cansat-ptl/cubesat-boards/cubesat-brdtemplate/cubesat-board.kicad_pcb

## KiCad design cubesat-brdtemplate/cubesat-board.kicad_pcb (2020-03-30)

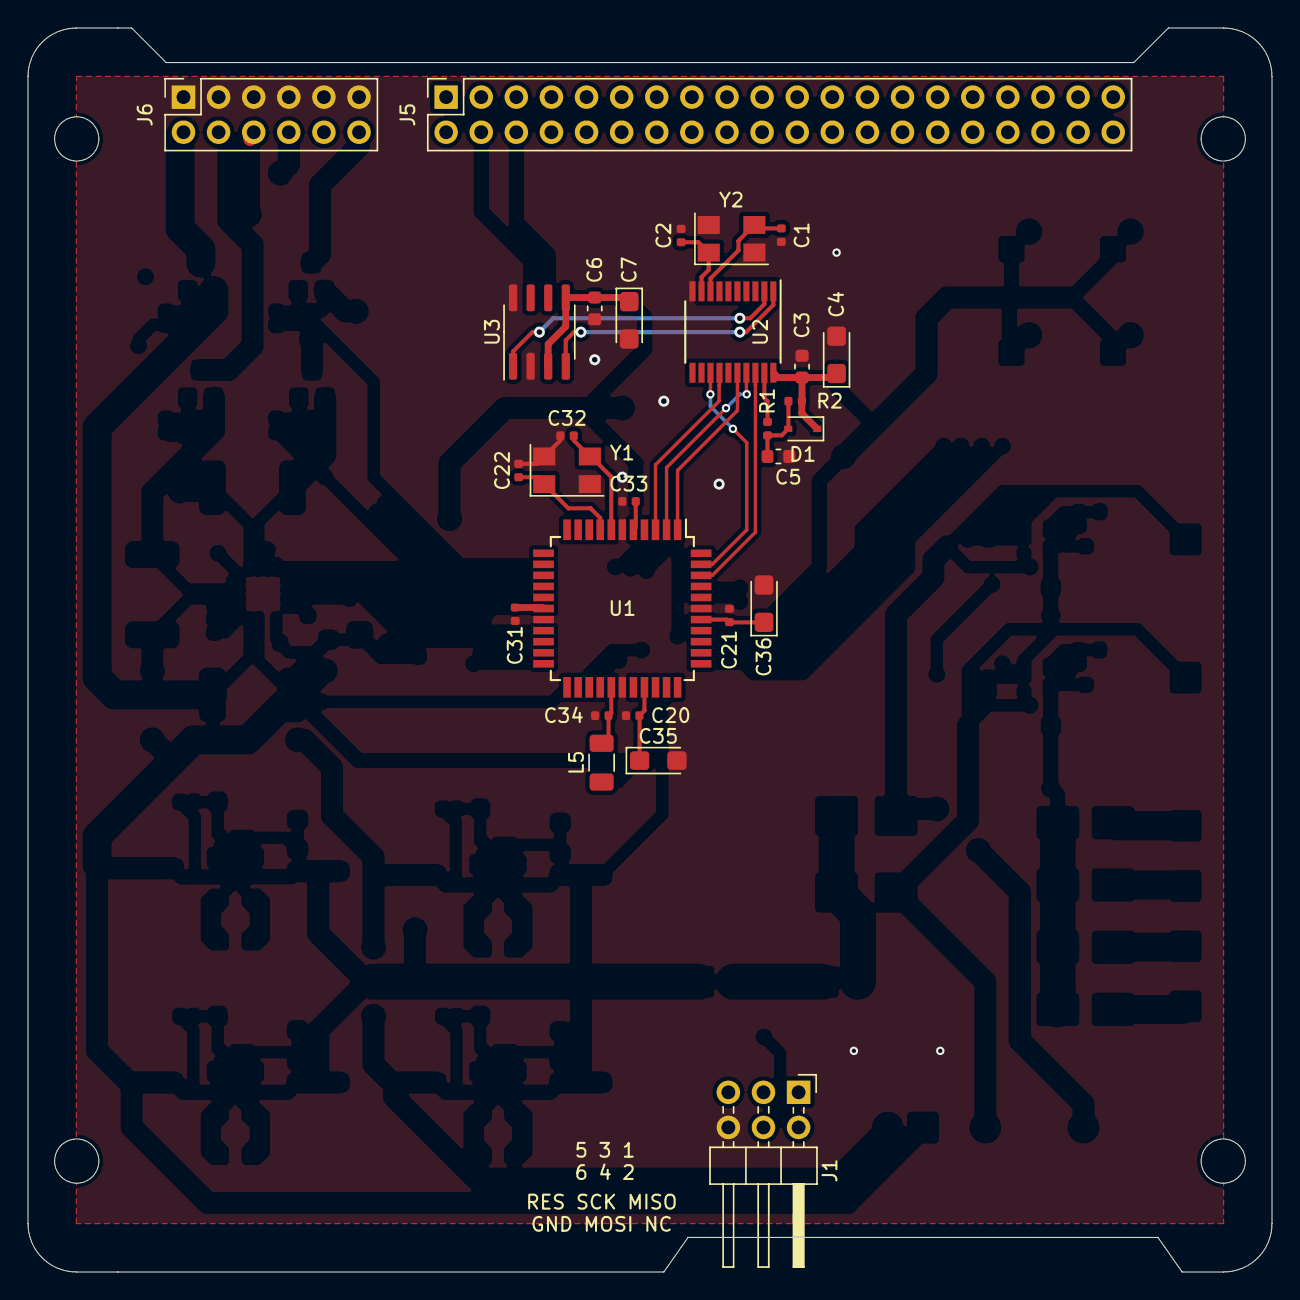
[picture p1: board cubesat-board.kicad_pcb from above]

Board: 2 copper layers, 90.0 x 90.0 mm, 28 parts (0 on the bottom side), 19 nets.

Parts:
C1, C2, C22, C32: 22pF; C_0402_1005Metric
C3, C5, C6: 100nF; C_0603_1608Metric
C4, C7, C35, C36: 22uF; CP_EIA-3216-10_Kemet-I
C20, C21, C31, C33, C34: 100nF; C_0402_1005Metric
D1: Generic; D_SOD-323
J1: ICSP; PinHeader_2x03_P2.54mm_Horizontal
J5: Conn_02x20_Odd_Even_MountingPin; PinSocket_2x20_P2.54mm_Vertical
J6: PWR_HEAD; PinSocket_2x06_P2.54mm_Vertical
L5: Ferrite; L_1206_3216Metric
R1, R2: 1K; R_0402_1005Metric
U1: ATmega644A-AU; TQFP-44_10x10mm_P0.8mm
U2: MCP2515-xST; TSSOP-20_4.4x6.5mm_P0.65mm
U3: TJA1051T-3; SOIC-8_3.9x4.9mm_P1.27mm
Y1: 8 MHz; Crystal_SMD_5032-4Pin_5.0x3.2mm
Y2: 12 MHz; Crystal_SMD_5032-4Pin_5.0x3.2mm

Connections:
+5V: C3.1, C4.1, C6.1, C7.1, C20.1, C21.1, C31.1, C33.1, C35.1, C36.1, D1.1, J6.8, L5.1, R2.1, U1.5, U1.17, U1.38, U2.20, U3.3, U3.5
/ICSP_MISO: J1.1, U1.2, U2.17
/ICSP_MOSI: J1.4, U1.1, U2.16
/ICSP_RESET: J1.5, U1.4
/ICSP_SCK: J1.3, U1.3, U2.14
/PWR_CANBUS/MCP_!CS: U1.42, U2.18
/PWR_CANBUS/MCP_!INT: U1.43, U2.13
CANH: J5.4, U3.7
CANL: J5.6, U3.6
GND: C1.2, C2.2, C3.2, C4.2, C5.2, C6.2, C7.2, C20.2, C21.2, C22.2, C31.2, C32.2, C33.2, C34.2, C35.2, C36.2, J1.6, J6.1, J6.3, J6.5, J6.7, J6.9, J6.11, U1.6, U1.18, U1.28, U1.39, U2.10, U3.2, U3.8, Y1.2, Y1.4, Y2.2, Y2.4
unnamed: C1.1, U2.8, Y2.3
unnamed: C2.1, U2.9, Y2.1
unnamed: C5.1, D1.2, R1.1, R2.2
unnamed: C22.1, U1.8, Y1.1
unnamed: C32.1, U1.7, Y1.3
unnamed: C34.1, L5.2, U1.27
unnamed: R1.2, U2.19
unnamed: U2.1, U3.4
unnamed: U2.2, U3.1
