cansat-ptl/cubesat-boards/cubesat-fcu/cubesat-fcu.kicad_pcb

## KiCad design cubesat-fcu/cubesat-fcu.kicad_pcb (2020-03-30)

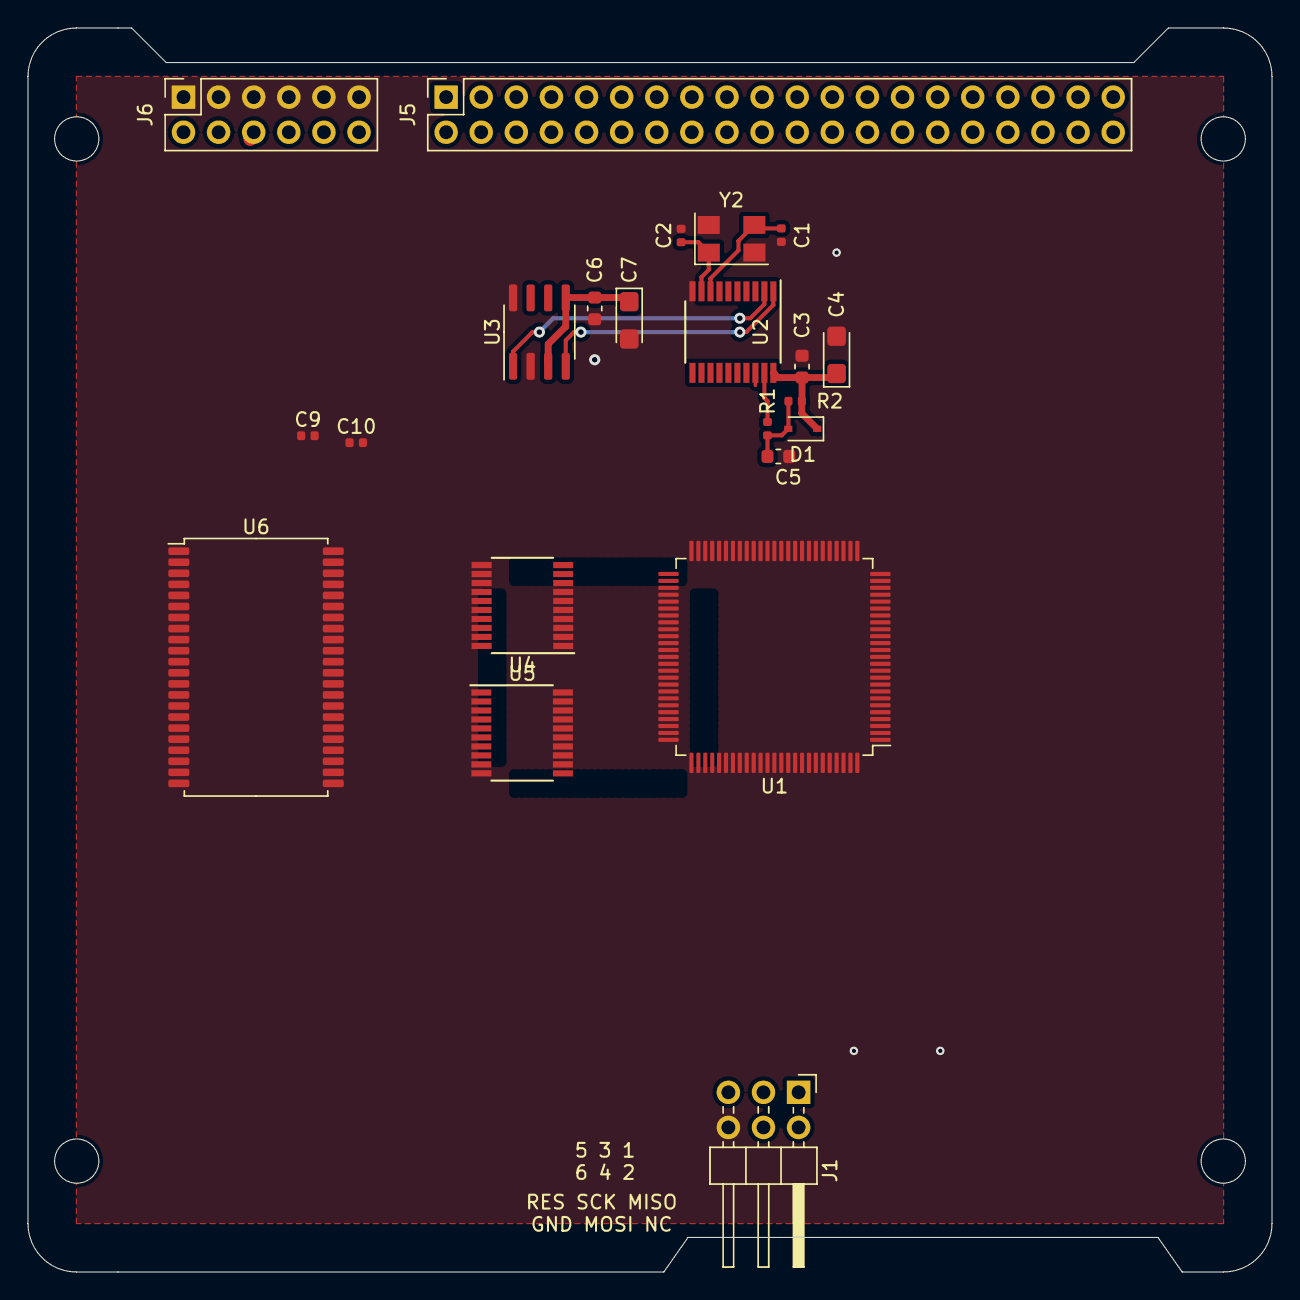
[picture p2: board cubesat-fcu.kicad_pcb from above]

Board: 2 copper layers, 90.0 x 90.0 mm, 22 parts (0 on the bottom side), 45 nets.

Parts:
C1, C2: 22pF; C_0402_1005Metric
C3, C5, C6: 100nF; C_0603_1608Metric
C4, C7: 22uF; CP_EIA-3216-10_Kemet-I
C9, C10: 100nF; C_0402_1005Metric
D1: Generic; D_SOD-323
J1: ICSP; PinHeader_2x03_P2.54mm_Horizontal
J5: Conn_02x20_Odd_Even_MountingPin; PinSocket_2x20_P2.54mm_Vertical
J6: PWR_HEAD; PinSocket_2x06_P2.54mm_Vertical
R1, R2: 1K; R_0402_1005Metric
U1: ATxmega128A1U-AU; TQFP-100_14x14mm_P0.5mm
U2: MCP2515-xST; TSSOP-20_4.4x6.5mm_P0.65mm
U3: TJA1051T-3; SOIC-8_3.9x4.9mm_P1.27mm
U4, U5: 74HC573#SOIC; TSSOP-20_4.4x6.5mm_P0.65mm
U6: IS61C5128AL-10TLI; TSOP-II-44_10.16x18.41mm_P0.8mm
Y2: 12 MHz; Crystal_SMD_5032-4Pin_5.0x3.2mm

Connections:
+3V3-A: C3.1, C4.1, C9.1, C10.1, D1.1, J6.6, R2.1, U2.20, U3.5, U4.20, U5.20, U6.11, U6.33
+5V-A: C6.1, C7.1, J6.2, U3.3
/FCU_MEMORY/FCU_ALE1: U1.57, U4.11
/FCU_MEMORY/FCU_ALE2: U1.58, U5.11
/FCU_MEMORY/FCU_MEM_~OE: U1.56, U6.37
/FCU_MEMORY/FCU_MEM_~WE: U1.55, U6.15
/PJ0: U1.65, U6.9
/PJ1: U1.66, U6.10
/PJ2: U1.67, U6.13
/PJ3: U1.68, U6.14
/PJ4: U1.69, U6.31
/PJ5: U1.70, U6.32
/PJ6: U1.71, U6.35
/PJ7: U1.72, U6.36
/PK0: U1.75, U4.2, U5.2, U6.3
/PK1: U1.76, U4.3, U5.3, U6.4
/PK2: U1.77, U4.4, U5.4, U6.5
/PK3: U1.78, U4.5, U6.6
/PK4: U1.79, U4.6, U6.7
/PK5: U1.80, U4.7, U6.16
/PK6: U1.81, U4.8, U6.17
/PK7: U1.82, U4.9, U6.18
CANH: J5.4, U3.7
CANL: J5.6, U3.6
GND: C1.2, C2.2, C3.2, C4.2, C5.2, C6.2, C7.2, C9.2, C10.2, J1.6, J5.1, J5.2, J5.3, J5.5, J5.7, J5.8, J6.1, J6.3, J6.5, J6.7, J6.9, J6.11, U2.10, U3.2, U3.8, U4.1, U4.10, U5.1, U5.10, U6.8, U6.12, U6.34, Y2.2, Y2.4
unnamed: C1.1, U2.8, Y2.3
unnamed: C2.1, U2.9, Y2.1
unnamed: C5.1, D1.2, R1.1, R2.2
unnamed: R1.2, U2.19
unnamed: U1.4, U1.94
unnamed: U1.3, U1.13, U1.23, U1.33, U1.43, U1.53, U1.63, U1.73, U1.84, U1.93
unnamed: U1.14, U1.24, U1.34, U1.44, U1.54, U1.64, U1.74, U1.83
unnamed: U2.1, U3.4
unnamed: U2.2, U3.1
unnamed: U4.12, U6.38
unnamed: U4.13, U6.30
unnamed: U4.14, U6.29
unnamed: U4.15, U6.28
unnamed: U4.16, U6.27
unnamed: U4.17, U6.26
unnamed: U4.18, U6.20
unnamed: U4.19, U6.19
unnamed: U5.17, U6.41
unnamed: U5.18, U6.40
unnamed: U5.19, U6.39
