cansat-ptl/cubesat-boards/cubesat-power/cubesat-power.kicad_pcb

## KiCad design cubesat-power/cubesat-power.kicad_pcb (2020-03-30)

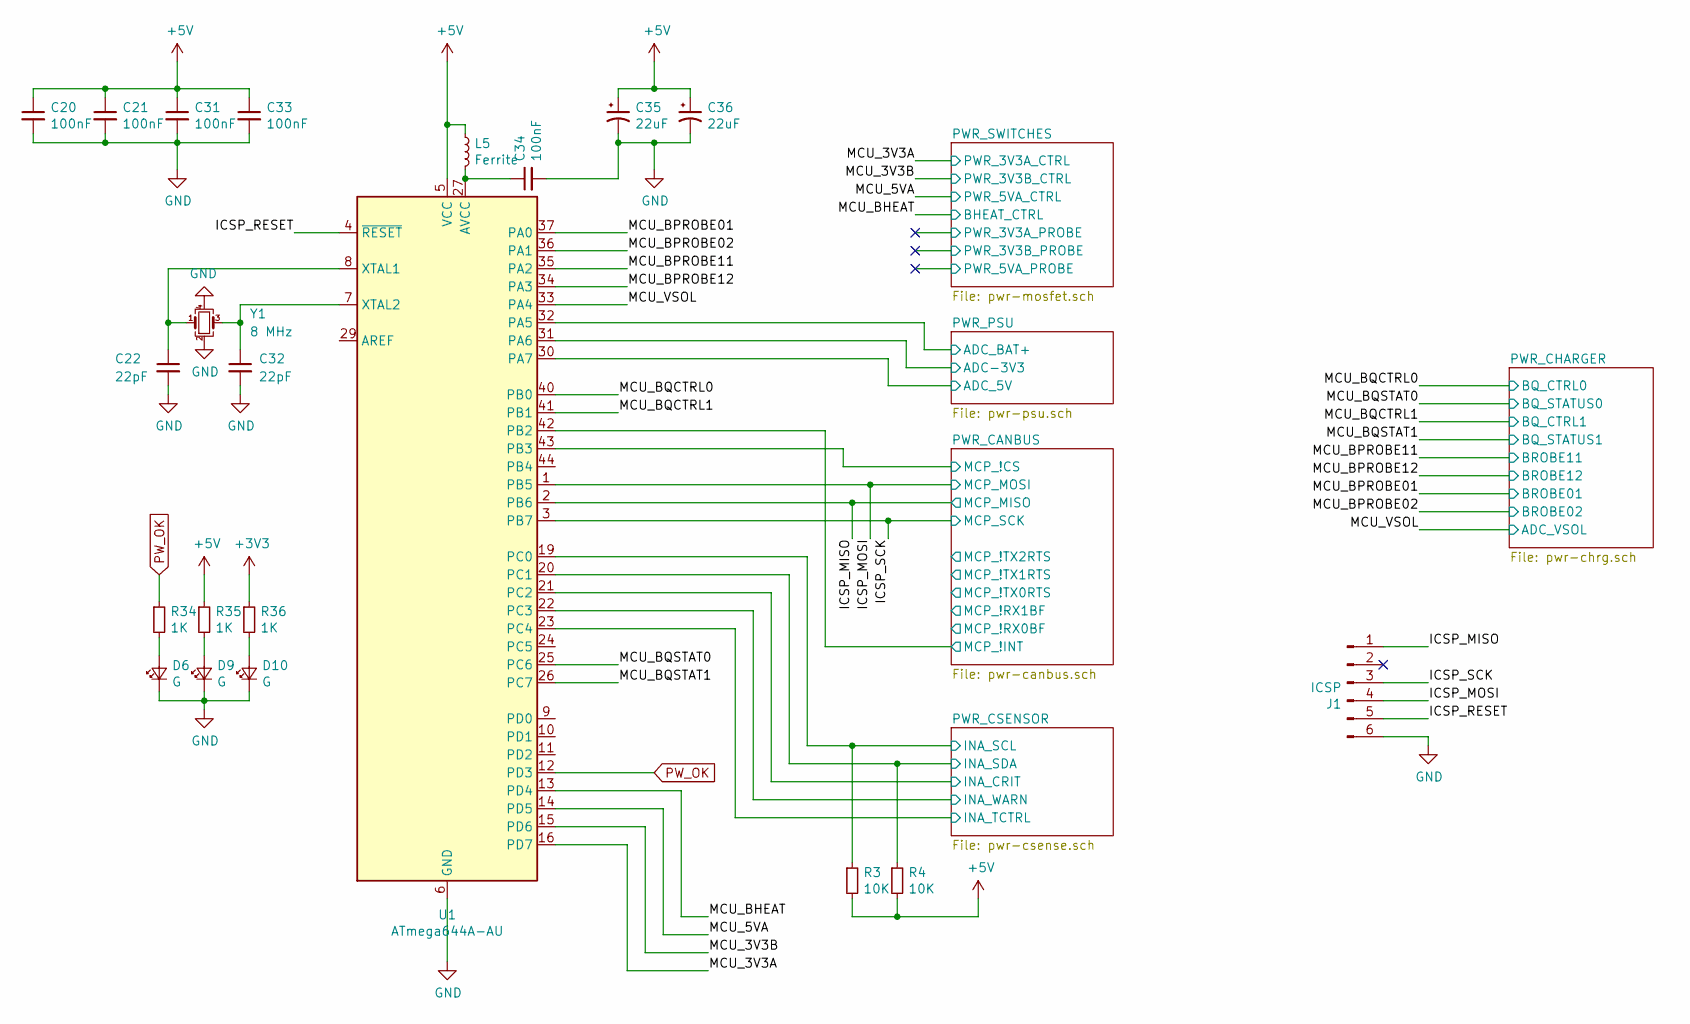
[picture p3: schematic cubesat-power.sch, Yktsat Power Supply Controller]

Parts:
C20, C21, C31, C33, C34: 100nF; C_0402_1005Metric
C22, C32: 22pF; C_0402_1005Metric
C35, C36: 22uF; CP_EIA-3216-10_Kemet-I
D6, D9, D10: G; LED_0603_1608Metric
J1: ICSP; PinHeader_2x03_P2.54mm_Horizontal
L5: Ferrite; L_1206_3216Metric
R3, R4: 10K; R_0402_1005Metric
R34, R35, R36: 1K; R_0603_1608Metric
U1: ATmega644A-AU; TQFP-44_10x10mm_P0.8mm
Y1: 8 MHz; Crystal_SMD_5032-4Pin_5.0x3.2mm; Part 7B-8.000MAAJ-T - CRYSTAL, 8MHZ, 18PF, 5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

Connections:
+3V3: R36.1; also elsewhere on the board
+5V: C20.1, C21.1, C31.1, C33.1, C35.1, C36.1, L5.1, R3.2, R4.2, R35.1, U1.5 (VCC), U1.17 (VCC), U1.30 (PA7), U1.38 (VCC); also elsewhere on the board
+BATT: U1.32 (PA5); also elsewhere on the board
/ICSP_MISO: J1.1, U1.2 (PB6); also elsewhere on the board
/ICSP_MOSI: J1.4, U1.1 (PB5); also elsewhere on the board
/ICSP_RESET: J1.5, U1.4 (~RESET)
/ICSP_SCK: J1.3, U1.3 (PB7); also elsewhere on the board
/MCU_3V3A: U1.16 (PD7); also elsewhere on the board
/MCU_3V3B: U1.15 (PD6); also elsewhere on the board
/MCU_5VA: U1.14 (PD5); also elsewhere on the board
/MCU_BHEAT: U1.13 (PD4); also elsewhere on the board
/MCU_BPROBE01: U1.37 (PA0); also elsewhere on the board
/MCU_BPROBE02: U1.36 (PA1); also elsewhere on the board
/MCU_BPROBE11: U1.35 (PA2); also elsewhere on the board
/MCU_BPROBE12: U1.34 (PA3); also elsewhere on the board
/MCU_BQCTRL0: U1.40 (PB0); also elsewhere on the board
/MCU_BQCTRL1: U1.41 (PB1); also elsewhere on the board
/MCU_BQSTAT0: U1.25 (PC6); also elsewhere on the board
/MCU_BQSTAT1: U1.26 (PC7); also elsewhere on the board
/MCU_VSOL: U1.33 (PA4); also elsewhere on the board
/PWR_CANBUS/MCP_!CS: U1.43 (PB3); also elsewhere on the board
/PWR_CANBUS/MCP_!INT: U1.42 (PB2); also elsewhere on the board
/PWR_CSENSOR/INA_CRIT: U1.21 (PC2); also elsewhere on the board
/PWR_CSENSOR/INA_SCL: R3.1, U1.19 (PC0); also elsewhere on the board
/PWR_CSENSOR/INA_SDA: R4.1, U1.20 (PC1); also elsewhere on the board
/PWR_CSENSOR/INA_TCTRL: U1.23 (PC4); also elsewhere on the board
/PWR_CSENSOR/INA_WARN: U1.22 (PC3); also elsewhere on the board
GND: C20.2, C21.2, C22.2, C31.2, C32.2, C33.2, C34.2, C35.2, C36.2, D6.1 (K), D9.1 (K), D10.1 (K), J1.6, U1.6 (GND), U1.18 (GND), U1.28 (GND), U1.39 (GND), Y1.2, Y1.4; also elsewhere on the board
unnamed: C22.1, U1.8 (XTAL1), Y1.1
unnamed: C32.1, U1.7 (XTAL2), Y1.3
unnamed: C34.1, L5.2, U1.27 (AVCC)
unnamed: D6.2 (A), R34.2
unnamed: D9.2 (A), R35.2
unnamed: D10.2 (A), R36.2
PW_OK: R34.1, U1.12 (PD3); also elsewhere on the board

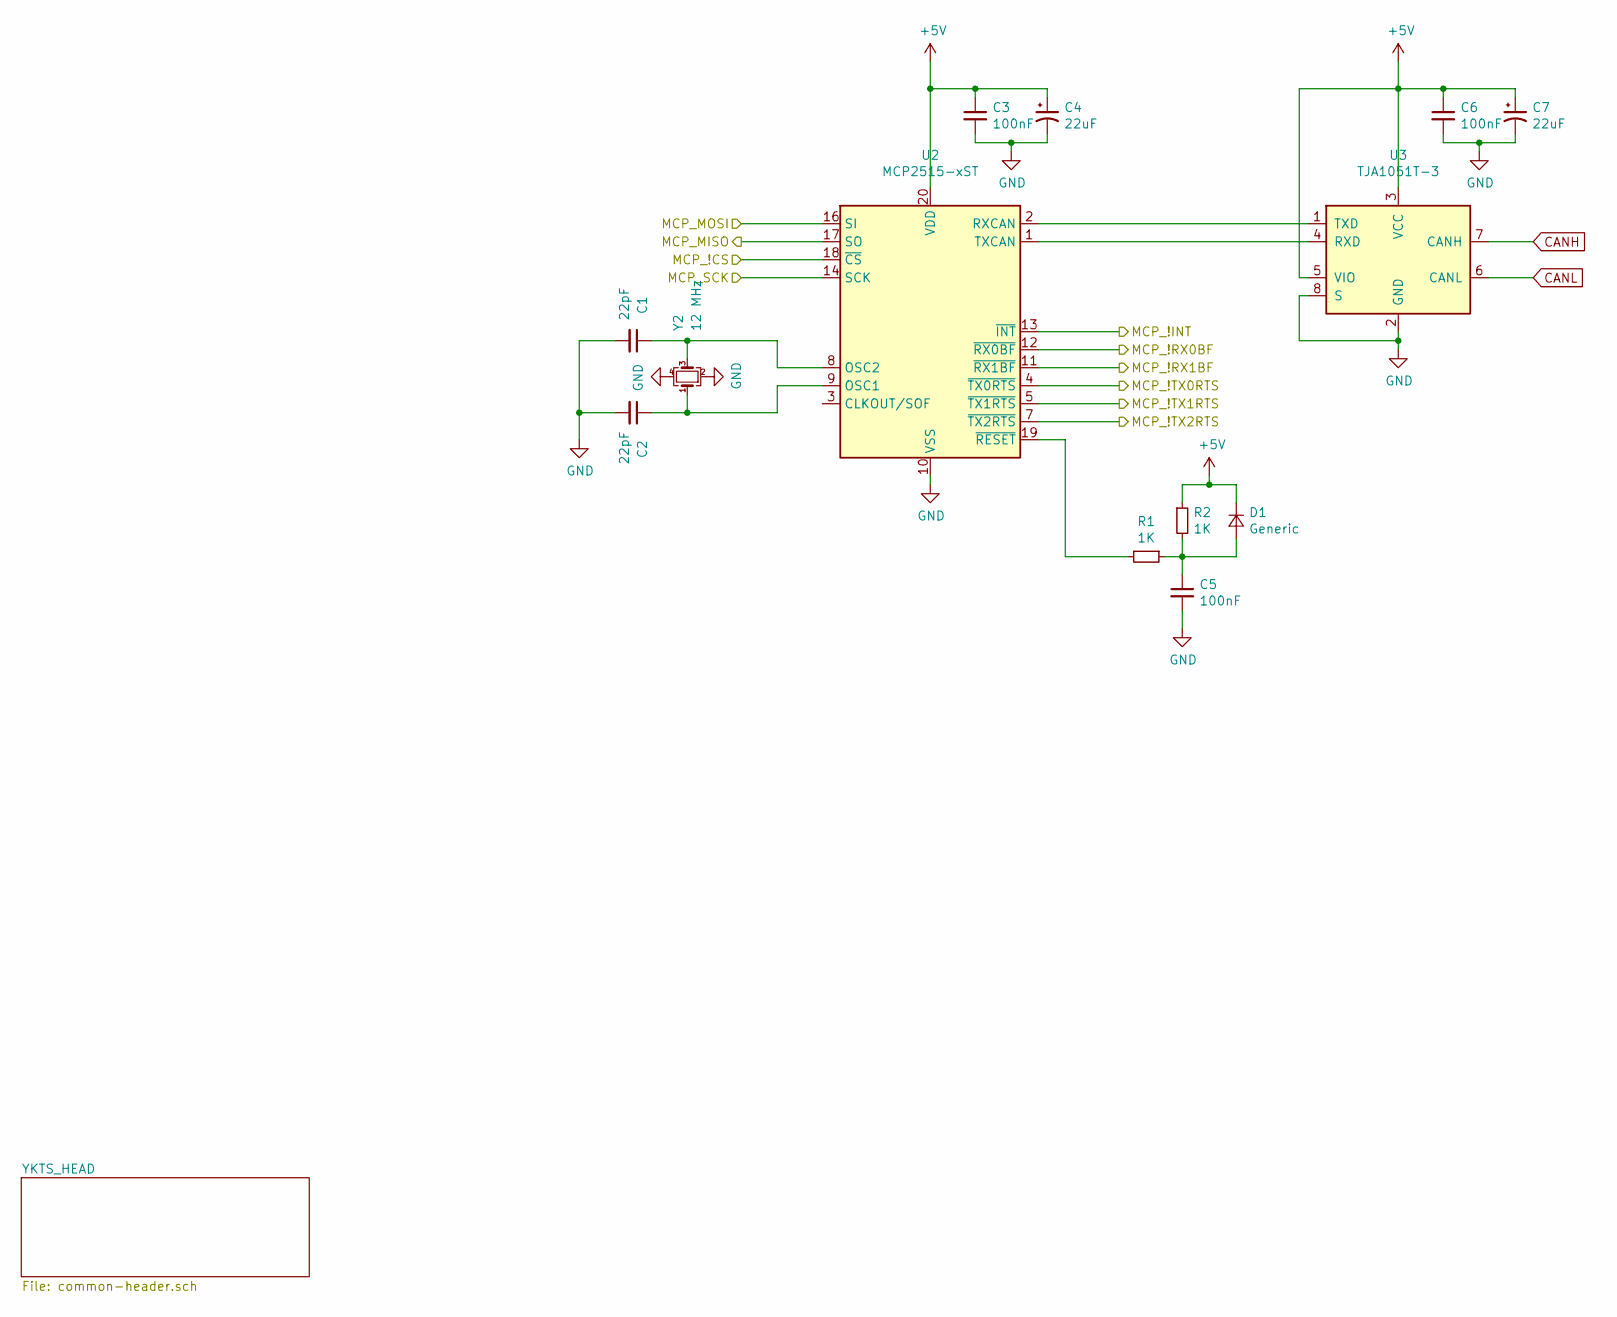
[picture p4: schematic pwr-canbus.sch, Yktsat CANBus Controller]

Parts:
C1, C2: 22pF; C_0402_1005Metric
C3, C5, C6: 100nF; C_0603_1608Metric
C4, C7: 22uF; CP_EIA-3216-10_Kemet-I
D1: Generic; D_SOD-323
R1, R2: 1K; R_0402_1005Metric
U2: MCP2515-xST; TSSOP-20_4.4x6.5mm_P0.65mm
U3: TJA1051T-3; SOIC-8_3.9x4.9mm_P1.27mm
Y2: 12 MHz; Crystal_SMD_5032-4Pin_5.0x3.2mm; Part AB-12.000MALE-T - CRYSTAL, 12MHZ, 12PF,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

Connections:
+5V: C3.1, C4.1, C6.1, C7.1, D1.1 (K), R2.1, U2.20 (VDD), U3.3 (VCC), U3.5 (VIO); also elsewhere on the board
/ICSP_MISO: U2.17 (SO); also elsewhere on the board
/ICSP_MOSI: U2.16 (SI); also elsewhere on the board
/ICSP_SCK: U2.14 (SCK); also elsewhere on the board
/PWR_CANBUS/MCP_!CS: U2.18 (~CS); also elsewhere on the board
/PWR_CANBUS/MCP_!INT: U2.13 (~INT); also elsewhere on the board
CANH: U3.7 (CANH); also elsewhere on the board
CANL: U3.6 (CANL); also elsewhere on the board
GND: C1.2, C2.2, C3.2, C4.2, C5.2, C6.2, C7.2, U2.10 (VSS), U3.2 (GND), U3.8 (S), Y2.2, Y2.4; also elsewhere on the board
unnamed: C1.1, U2.8 (OSC2), Y2.3
unnamed: C2.1, U2.9 (OSC1), Y2.1
unnamed: C5.1, D1.2 (A), R1.1, R2.2
unnamed: R1.2, U2.19 (~RESET)
unnamed: U2.1 (TXCAN), U3.4 (RXD)
unnamed: U2.2 (RXCAN), U3.1 (TXD)

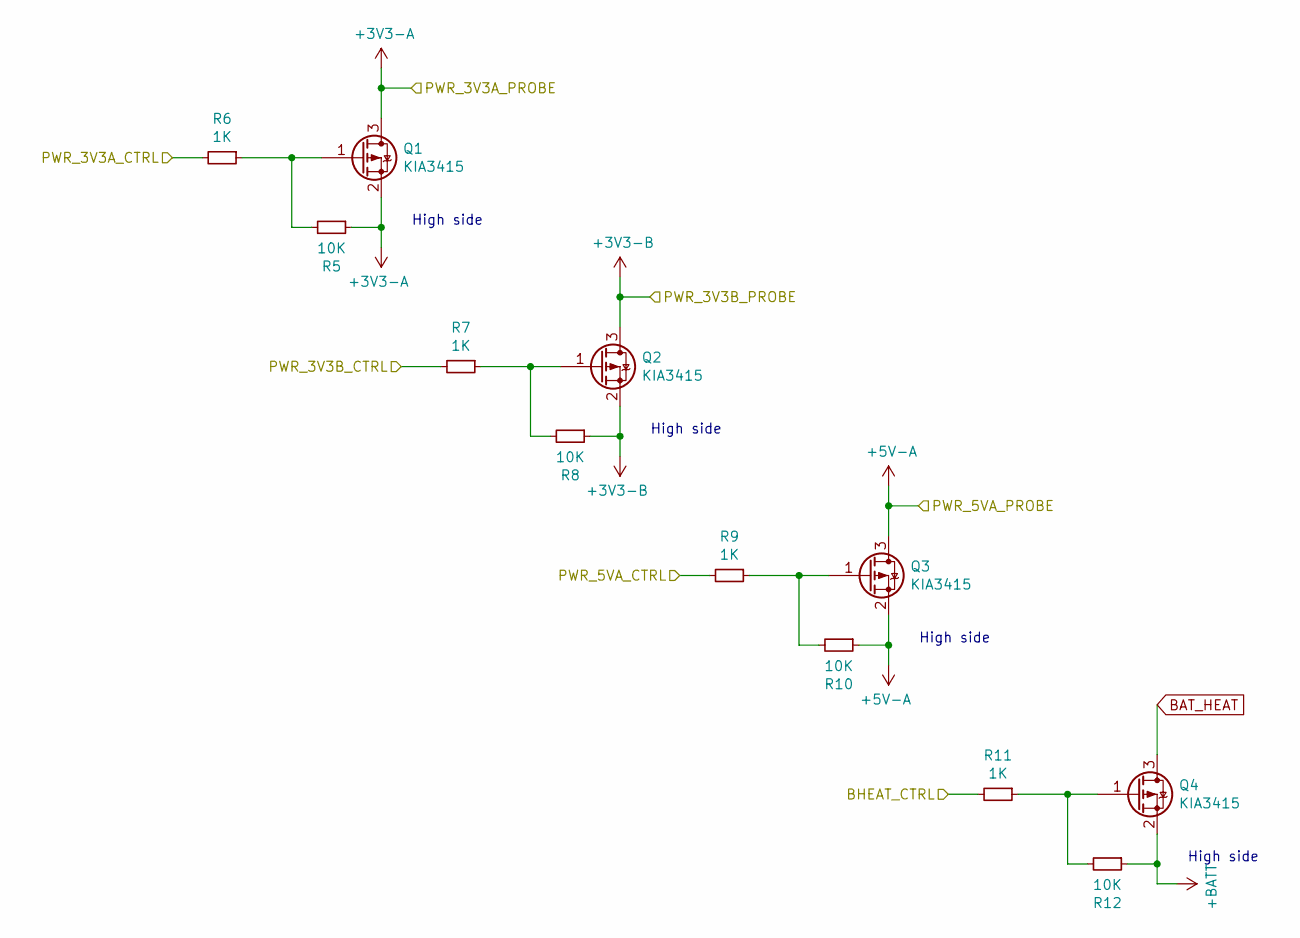
[picture p5: schematic pwr-mosfet.sch, Yktsat Power Supply Switches]

Parts:
Q1, Q2, Q3, Q4: KIA3415; SOT-23
R5, R8, R10, R12: 10K; R_0402_1005Metric
R6, R7, R9, R11: 1K; R_0402_1005Metric

Connections:
+3V3-A: Q1.2 (S), Q1.3 (D), R5.1; also elsewhere on the board
+3V3-B: Q2.2 (S), Q2.3 (D), R8.1; also elsewhere on the board
+5V-A: Q3.2 (S), Q3.3 (D), R10.1; also elsewhere on the board
+BATT: Q4.2 (S), R12.1; also elsewhere on the board
/MCU_3V3A: R6.2; also elsewhere on the board
/MCU_3V3B: R7.2; also elsewhere on the board
/MCU_5VA: R9.2; also elsewhere on the board
/MCU_BHEAT: R11.2; also elsewhere on the board
BAT_HEAT: Q4.3 (D); also elsewhere on the board
unnamed: Q1.1 (G), R5.2, R6.1
unnamed: Q2.1 (G), R7.1, R8.2
unnamed: Q3.1 (G), R9.1, R10.2
unnamed: Q4.1 (G), R11.1, R12.2

Notes on the sheet:
High side

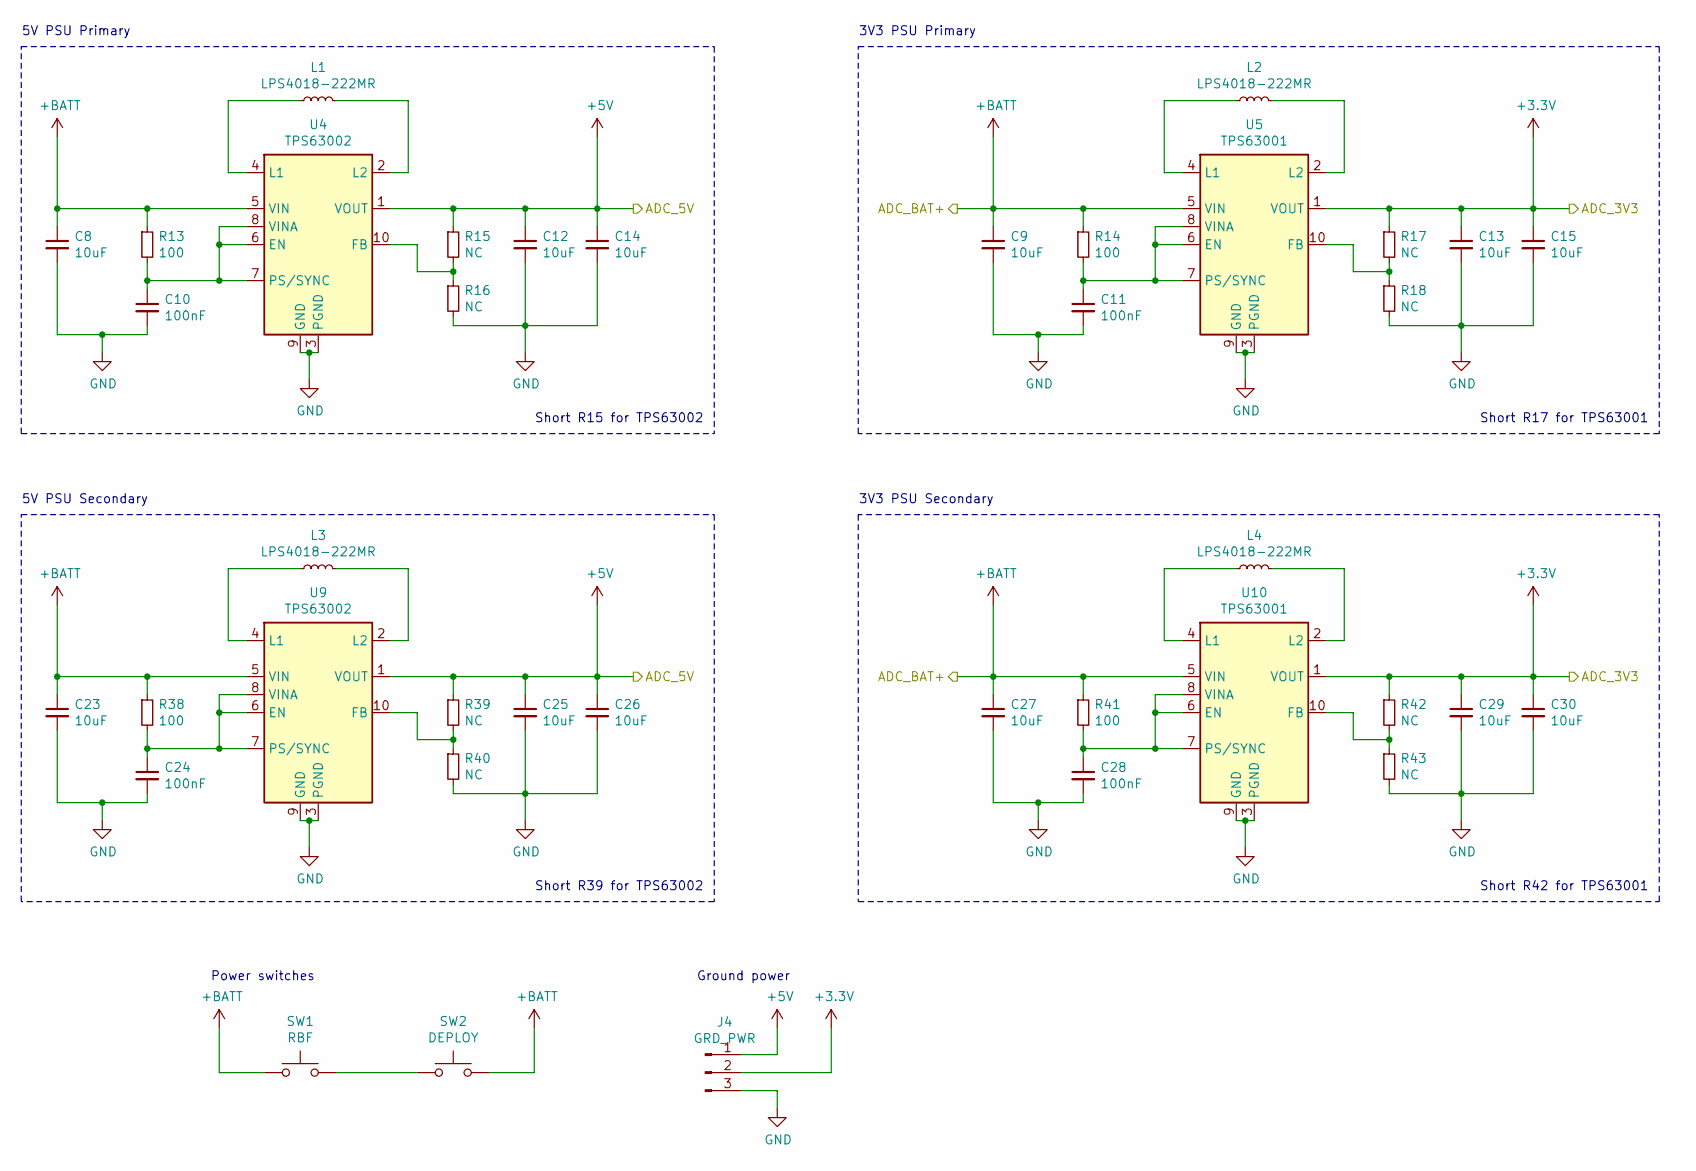
[picture p6: schematic pwr-psu.sch, Yktsat Main PSU]

Parts:
C8, C9, C12, C13, C14, C15, C23, C25, C26, C27, C29, C30: 10uF; C_0603_1608Metric
C10, C11, C24, C28: 100nF; C_0603_1608Metric
J4: GRD_PWR; PinHeader_1x03_P2.54mm_Horizontal
L1, L2, L3, L4: LPS4018-222MR; L_Coilcraft_LPS4018
R13, R14, R38, R41: 100; R_0603_1608Metric
R15, R17, R39, R42: NC; C_0402_1005Metric
R16, R18, R40, R43: NC; R_0603_1608Metric
SW1: RBF; PinHeader_1x02_P2.54mm_Vertical
SW2: DEPLOY; PinHeader_1x02_P2.54mm_Vertical
U4, U9: TPS63002; Texas_DRC0010J_ThermalVias
U5, U10: TPS63001; Texas_DRC0010J_ThermalVias

Connections:
+3V3: C13.1, C15.1, C29.1, C30.1, J4.2, R17.1, R42.1, U5.1 (VOUT), U10.1 (VOUT); also elsewhere on the board
+5V: C12.1, C14.1, C25.1, C26.1, J4.1, R15.1, R39.1, U4.1 (VOUT), U9.1 (VOUT); also elsewhere on the board
+BATT: C8.1, C9.1, C23.1, C27.1, R13.1, R14.1, R38.1, R41.1, SW1.1, SW2.2, U4.5 (VIN), U5.5 (VIN), U9.5 (VIN), U10.5 (VIN); also elsewhere on the board
GND: C8.2, C9.2, C10.2, C11.2, C12.2, C13.2, C14.2, C15.2, C23.2, C24.2, C25.2, C26.2, C27.2, C28.2, C29.2, C30.2, J4.3, R16.2, R18.2, R40.2, R43.2, U4.3 (PGND), U4.9 (GND), U4.11 (PGND), U5.3 (PGND), U5.9 (GND), U5.11 (PGND), U9.3 (PGND), U9.9 (GND), U9.11 (PGND), U10.3 (PGND), U10.9 (GND), U10.11 (PGND); also elsewhere on the board
unnamed: C10.1, R13.2, U4.6 (EN), U4.7 (PS/SYNC), U4.8 (VINA)
unnamed: C11.1, R14.2, U5.6 (EN), U5.7 (PS/SYNC), U5.8 (VINA)
unnamed: C24.1, R38.2, U9.6 (EN), U9.7 (PS/SYNC), U9.8 (VINA)
unnamed: C28.1, R41.2, U10.6 (EN), U10.7 (PS/SYNC), U10.8 (VINA)
unnamed: L1.1, U4.4 (L1)
unnamed: L1.2, U4.2 (L2)
unnamed: L2.1, U5.4 (L1)
unnamed: L2.2, U5.2 (L2)
unnamed: L3.1, U9.4 (L1)
unnamed: L3.2, U9.2 (L2)
unnamed: L4.1, U10.4 (L1)
unnamed: L4.2, U10.2 (L2)
unnamed: R15.2, R16.1, U4.10 (FB)
unnamed: R17.2, R18.1, U5.10 (FB)
unnamed: R39.2, R40.1, U9.10 (FB)
unnamed: R42.2, R43.1, U10.10 (FB)
unnamed: SW1.2, SW2.1

Notes on the sheet:
5V PSU Secondary
5V PSU Primary
3V3 PSU Primary
3V3 PSU Secondary
Power switches
Ground power
Short R15 for TPS63002
Short R39 for TPS63002
Short R17 for TPS63001
Short R42 for TPS63001

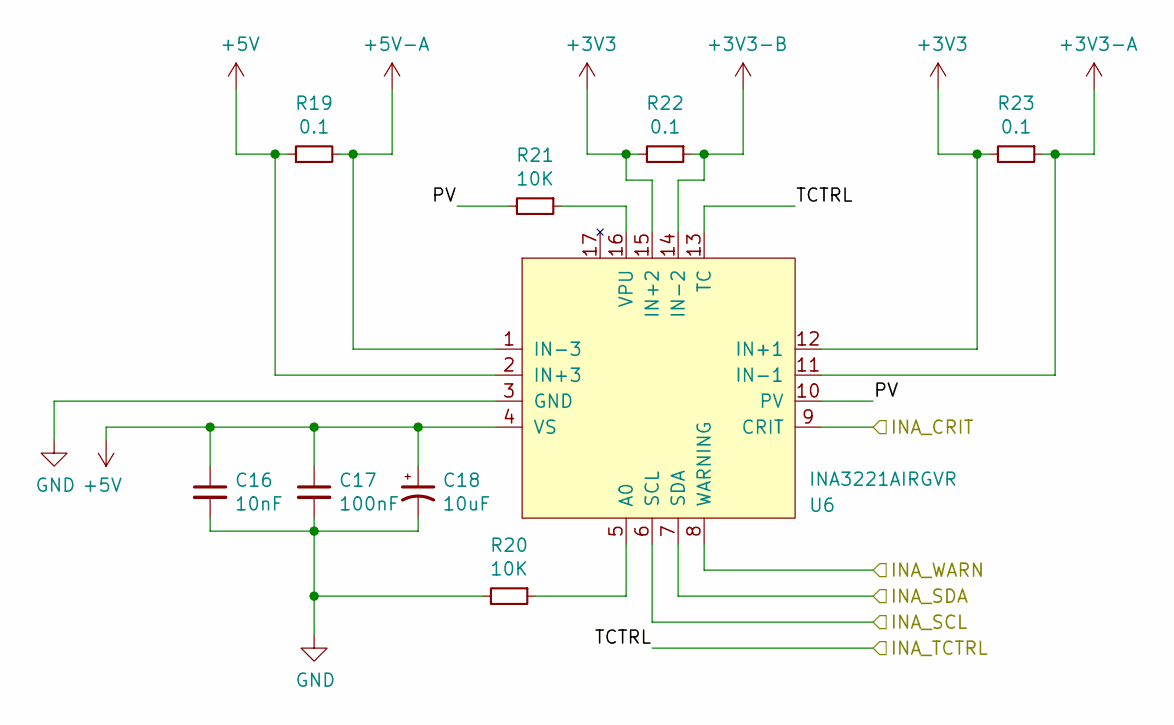
[picture p7: schematic pwr-csense.sch, Yktsat PSU Current Sensor]

Parts:
C16: 10nF; C_0402_1005Metric
C17: 100nF; C_0603_1608Metric
C18: 10uF; CP_EIA-3216-10_Kemet-I
R19, R22, R23: 0.1; R_2512_6332Metric
R20, R21: 10K; R_0402_1005Metric
U6: INA3221AIRGVR; QFN-16-1EP_4x4mm_P0.65mm_EP2.1x2.1mm

Connections:
+3V3: R22.2, R23.2, U6.12 (IN+1), U6.15 (IN+2); also elsewhere on the board
+3V3-A: R23.1, U6.11 (IN-1); also elsewhere on the board
+3V3-B: R22.1, U6.14 (IN-2); also elsewhere on the board
+5V: C16.1, C17.1, C18.1, R19.1, U6.2 (IN+3), U6.4 (VS); also elsewhere on the board
+5V-A: R19.2, U6.1 (IN-3); also elsewhere on the board
/PWR_CSENSOR/INA_CRIT: U6.9 (CRIT); also elsewhere on the board
/PWR_CSENSOR/INA_SCL: U6.6 (SCL); also elsewhere on the board
/PWR_CSENSOR/INA_SDA: U6.7 (SDA); also elsewhere on the board
/PWR_CSENSOR/INA_TCTRL: U6.13 (TC); also elsewhere on the board
/PWR_CSENSOR/INA_WARN: U6.8 (WARNING); also elsewhere on the board
/PWR_CSENSOR/PV: R21.2, U6.10 (PV)
GND: C16.2, C17.2, C18.2, R20.2, U6.3 (GND); also elsewhere on the board
unnamed: R20.1, U6.5 (A0)
unnamed: R21.1, U6.16 (VPU)

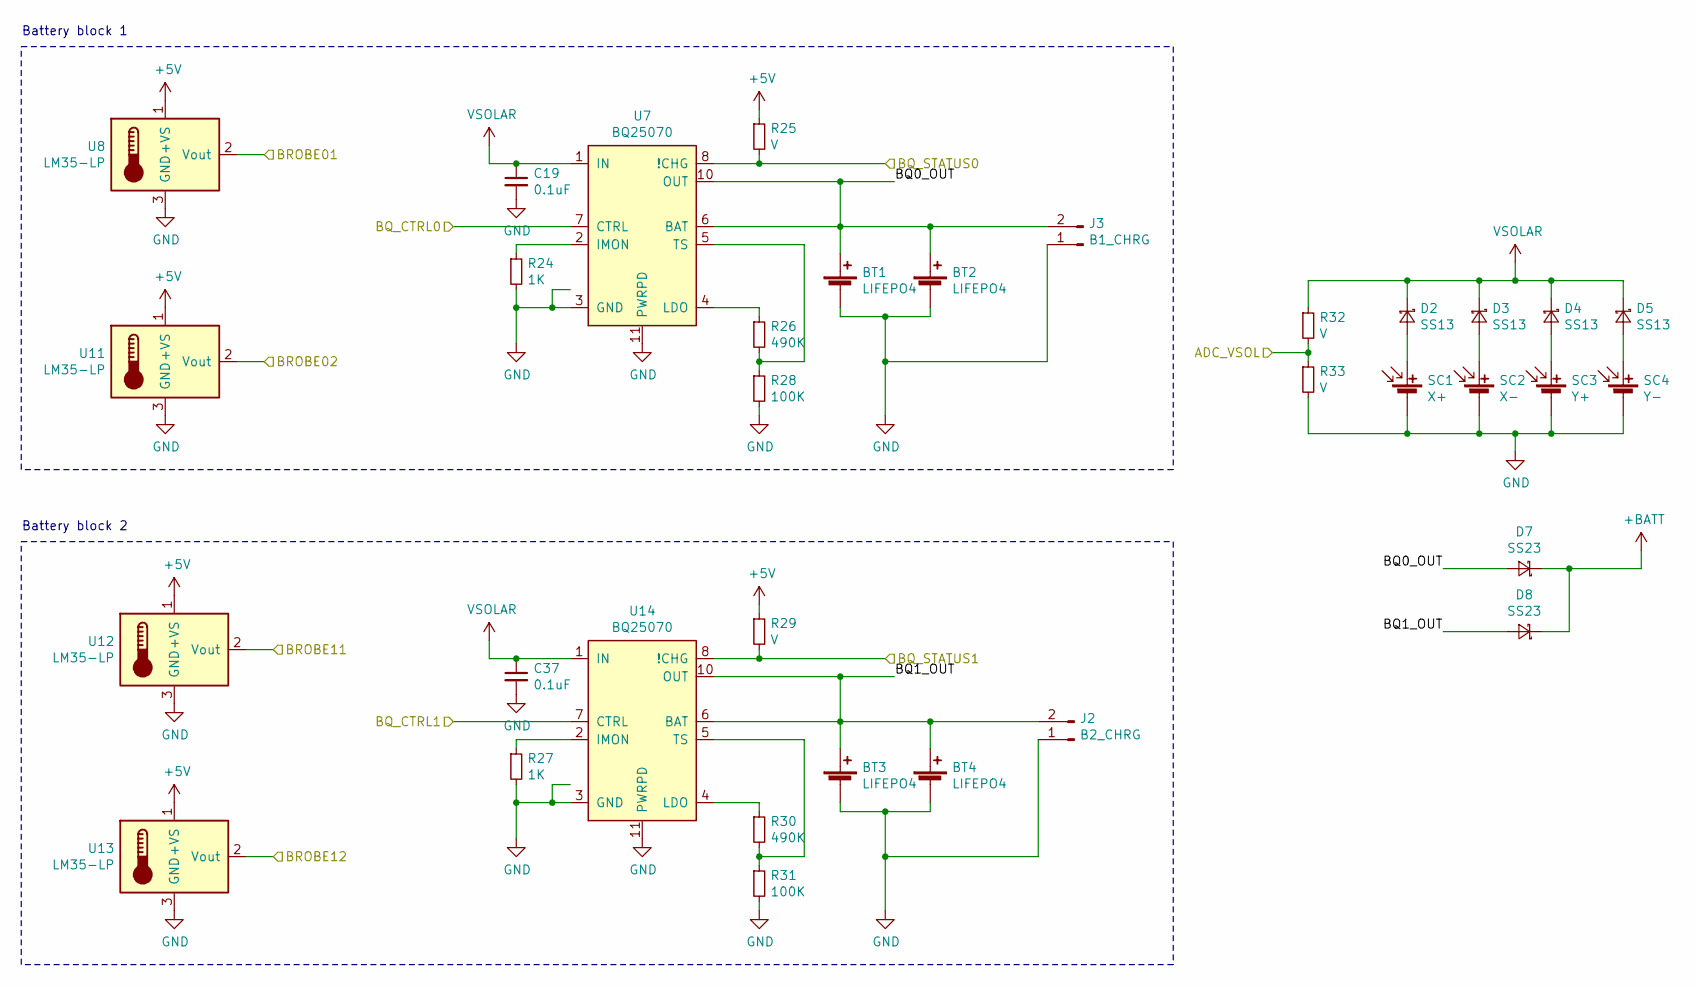
[picture p8: schematic pwr-chrg.sch, Yksat LiFePO4 Battery Charger Module]

Parts:
BT1, BT3: LIFEPO4; PinHeader_1x02_P2.54mm_Vertical
BT2, BT4: LIFEPO4
C19, C37: 0.1uF; C_0603_1608Metric
D2, D3, D4, D5: SS13; D_SMA
D7, D8: SS23; D_SMB
J2: B2_CHRG; PinHeader_1x02_P2.54mm_Horizontal
J3: B1_CHRG; PinHeader_1x02_P2.54mm_Horizontal
R24, R27: 1K; R_0402_1005Metric
R25, R29: V; R_0402_1005Metric
R26, R30: 490K; R_0402_1005Metric
R28, R31: 100K; R_0402_1005Metric
R32, R33: V; R_0603_1608Metric
SC1: X+; PinHeader_1x02_P2.54mm_Vertical
SC2: X-; PinHeader_1x02_P2.54mm_Vertical
SC3: Y+; PinHeader_1x02_P2.54mm_Vertical
SC4: Y-; PinHeader_1x02_P2.54mm_Vertical
U7, U14: BQ25070; WSON-10-1EP_2x3mm_P0.5mm_EP0.84x2.4mm
U8, U11, U12, U13: LM35-LP; TO-92

Connections:
+5V: R25.1, R29.1, U8.1 (+VS), U11.1 (+VS), U12.1 (+VS), U13.1 (+VS); also elsewhere on the board
+BATT: D7.1 (K), D8.1 (K); also elsewhere on the board
/MCU_BPROBE01: U8.2 (Vout); also elsewhere on the board
/MCU_BPROBE02: U11.2 (Vout); also elsewhere on the board
/MCU_BPROBE11: U12.2 (Vout); also elsewhere on the board
/MCU_BPROBE12: U13.2 (Vout); also elsewhere on the board
/MCU_BQCTRL0: U7.7 (CTRL); also elsewhere on the board
/MCU_BQCTRL1: U14.7 (CTRL); also elsewhere on the board
/MCU_BQSTAT0: R25.2, U7.8 (!CHG); also elsewhere on the board
/MCU_BQSTAT1: R29.2, U14.8 (!CHG); also elsewhere on the board
/MCU_VSOL: R32.2, R33.1; also elsewhere on the board
/PWR_CHARGER/BQ0_OUT: BT1.1 (+), BT2.1 (+), D7.2 (A), J3.2, U7.6 (BAT), U7.10 (OUT)
/PWR_CHARGER/BQ1_OUT: BT3.1 (+), BT4.1 (+), D8.2 (A), J2.2, U14.6 (BAT), U14.10 (OUT)
GND: BT1.2 (-), BT2.2 (-), BT3.2 (-), BT4.2 (-), C19.2, C37.2, J2.1, J3.1, R24.2, R27.2, R28.2, R31.2, R33.2, SC1.2 (-), SC2.2 (-), SC3.2 (-), SC4.2 (-), U7.3 (GND), U7.9 (GND), U7.11 (PWRPD), U8.3 (GND), U11.3 (GND), U12.3 (GND), U13.3 (GND), U14.3 (GND), U14.9 (GND), U14.11 (PWRPD); also elsewhere on the board
unnamed: D2.2 (A), SC1.1 (+)
unnamed: D3.2 (A), SC2.1 (+)
unnamed: D4.2 (A), SC3.1 (+)
unnamed: D5.2 (A), SC4.1 (+)
unnamed: R24.1, U7.2 (IMON)
unnamed: R26.1, U7.4 (LDO)
unnamed: R26.2, R28.1, U7.5 (TS)
unnamed: R27.1, U14.2 (IMON)
unnamed: R30.1, U14.4 (LDO)
unnamed: R30.2, R31.1, U14.5 (TS)
VSOLAR: C19.1, C37.1, D2.1 (K), D3.1 (K), D4.1 (K), D5.1 (K), R32.1, U7.1 (IN), U14.1 (IN)

Notes on the sheet:
Battery block 1
Battery block 2

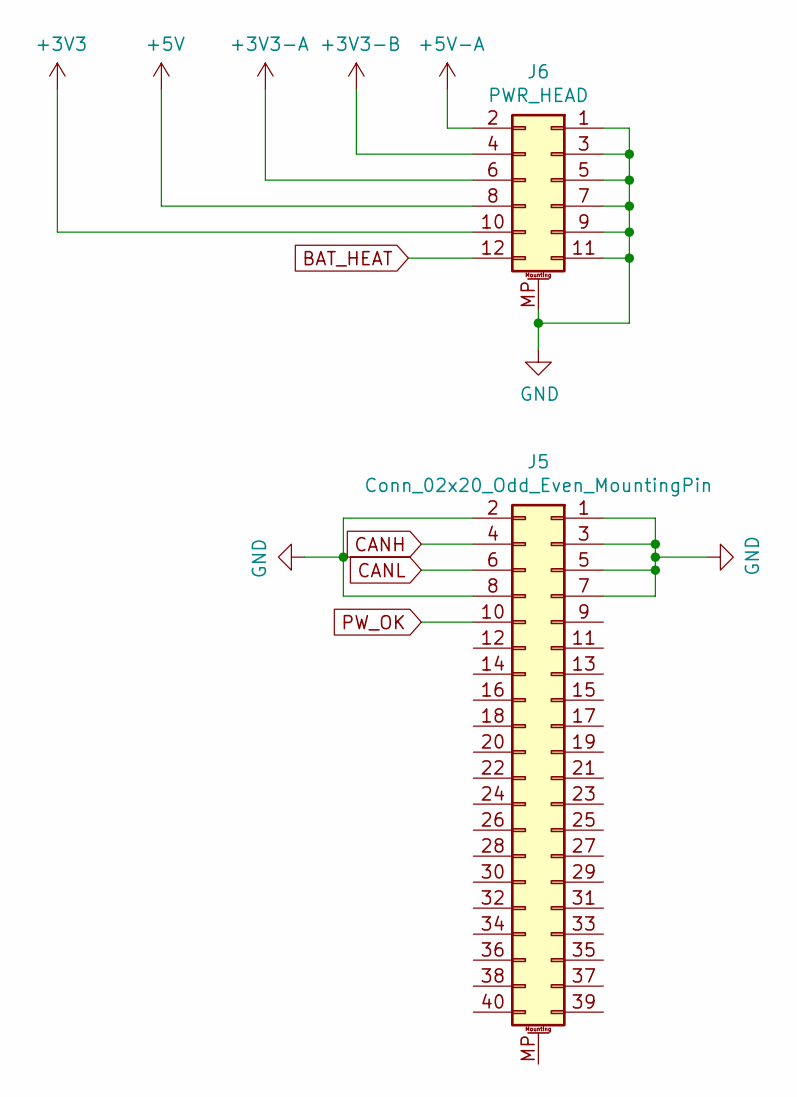
[picture p9: schematic common-header.sch, Yktsat Main Header]

Parts:
J5: Conn_02x20_Odd_Even_MountingPin; PinSocket_2x20_P2.54mm_Vertical
J6: PWR_HEAD; PinSocket_2x06_P2.54mm_Vertical

Connections:
+3V3: J6.10; also elsewhere on the board
+3V3-A: J6.6; also elsewhere on the board
+3V3-B: J6.4; also elsewhere on the board
+5V: J6.8; also elsewhere on the board
+5V-A: J6.2; also elsewhere on the board
BAT_HEAT: J6.12; also elsewhere on the board
CANH: J5.4; also elsewhere on the board
CANL: J5.6; also elsewhere on the board
GND: J5.1, J5.2, J5.3, J5.5, J5.7, J5.8, J6.1, J6.3, J6.5, J6.7, J6.9, J6.11, J6.MP (MountPin); also elsewhere on the board
PW_OK: J5.10; also elsewhere on the board
