cansat-ptl/cubesat-boards/cubesat-power/cubesat-power.kicad_pcb

## KiCad design cubesat-power/cubesat-power.kicad_pcb (continued)

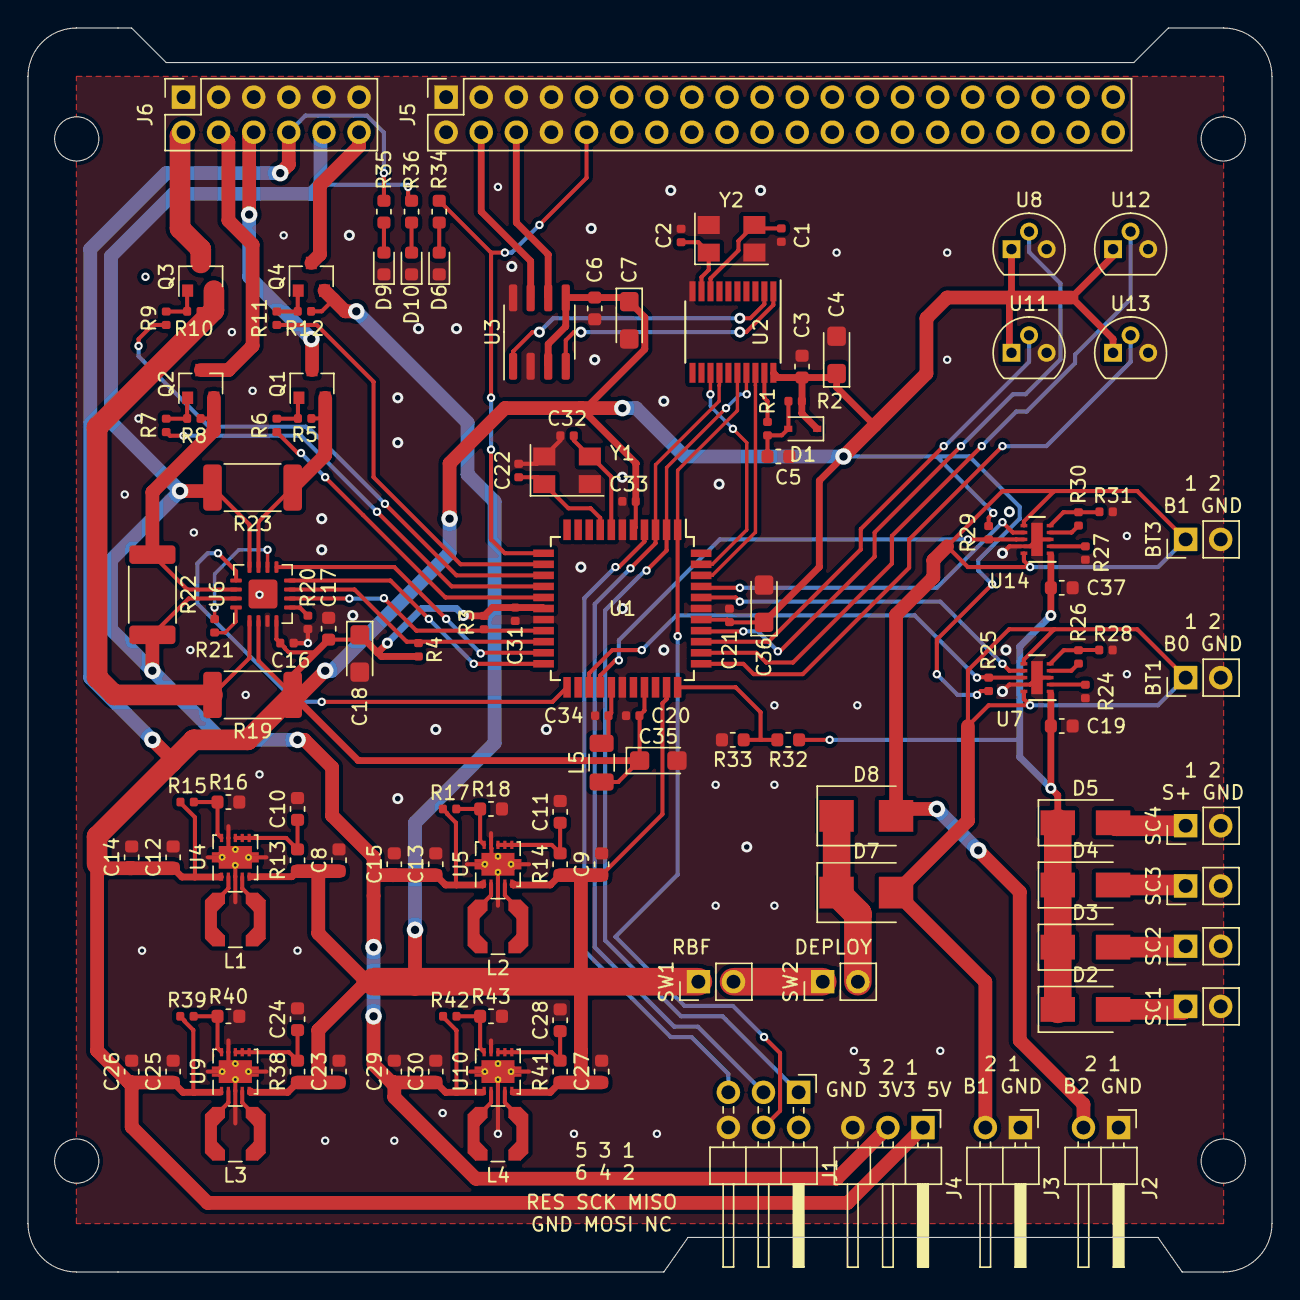
[picture p10: board cubesat-power.kicad_pcb from above]

Board: 2 copper layers, 90.0 x 90.0 mm, 128 parts (0 on the bottom side), 84 nets.
