cansat-ptl/cubesat-boards/(commit log)

2020-03-30 Initial upload
    [brd-canbus.sch, common-header.sch, cubesat-board.kicad_pcb, cubesat-board.sch, cubesat-fcu.kicad_pcb, cubesat-fcu.sch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]
2020-03-31 Broke everything
    [brd-canbus.sch, common-header.sch, cubesat-fcu.sch, fcu-mem.sch, fcu-mram.sch]
